ersatzavian/pai/Release/Rev-02/Fabrication/Reports/DRC/pai.html

Altium

# Design Rule Verification Report

Date: | | 2/10/2019
Time: | | 4:48:34 PM
Elapsed Time: | | 00:00:00
Filename: | | C:\Users\tbyrne\AppData\Local\TempReleases\Snapshot\1\Pcb\pai.PcbDoc

Warnings: | | 0
Rule Violations: | | 0

## Summary

Warnings | Count
Total | 0

Rule Violations | Count
Clearance Constraint (Gap=10mil) (All),(All) | 0
Short-Circuit Constraint (Allowed=No) (All),(All) | 0
Un-Routed Net Constraint ( (All) ) | 0
Modified Polygon (Allow modified: No), (Allow shelved: No) | 0
Width Constraint (Min=8mil) (Max=35mil) (Preferred=10mil) (All) | 0
Power Plane Connect Rule(Relief Connect )(Expansion=20mil) (Conductor Width=10mil) (Air Gap=10mil) (Entries=4) (All) | 0
Hole Size Constraint (Min=15mil) (Max=100mil) (All) | 0
Hole To Hole Clearance (Gap=10mil) (All),(All) | 0
Minimum Solder Mask Sliver (Gap=7mil) (All),(All) | 0
Silk To Solder Mask (Clearance=2mil) (IsPad),(All) | 0
Silk to Silk (Clearance=5mil) (All),(All) | 0
Net Antennae (Tolerance=0mil) (All) | 0
Height Constraint (Min=0mil) (Max=3000mil) (Prefered=500mil) (All) | 0
Total | 0
