ersatzavian/pai/Docs/0_5in_DC_jack_w_lift.PNG

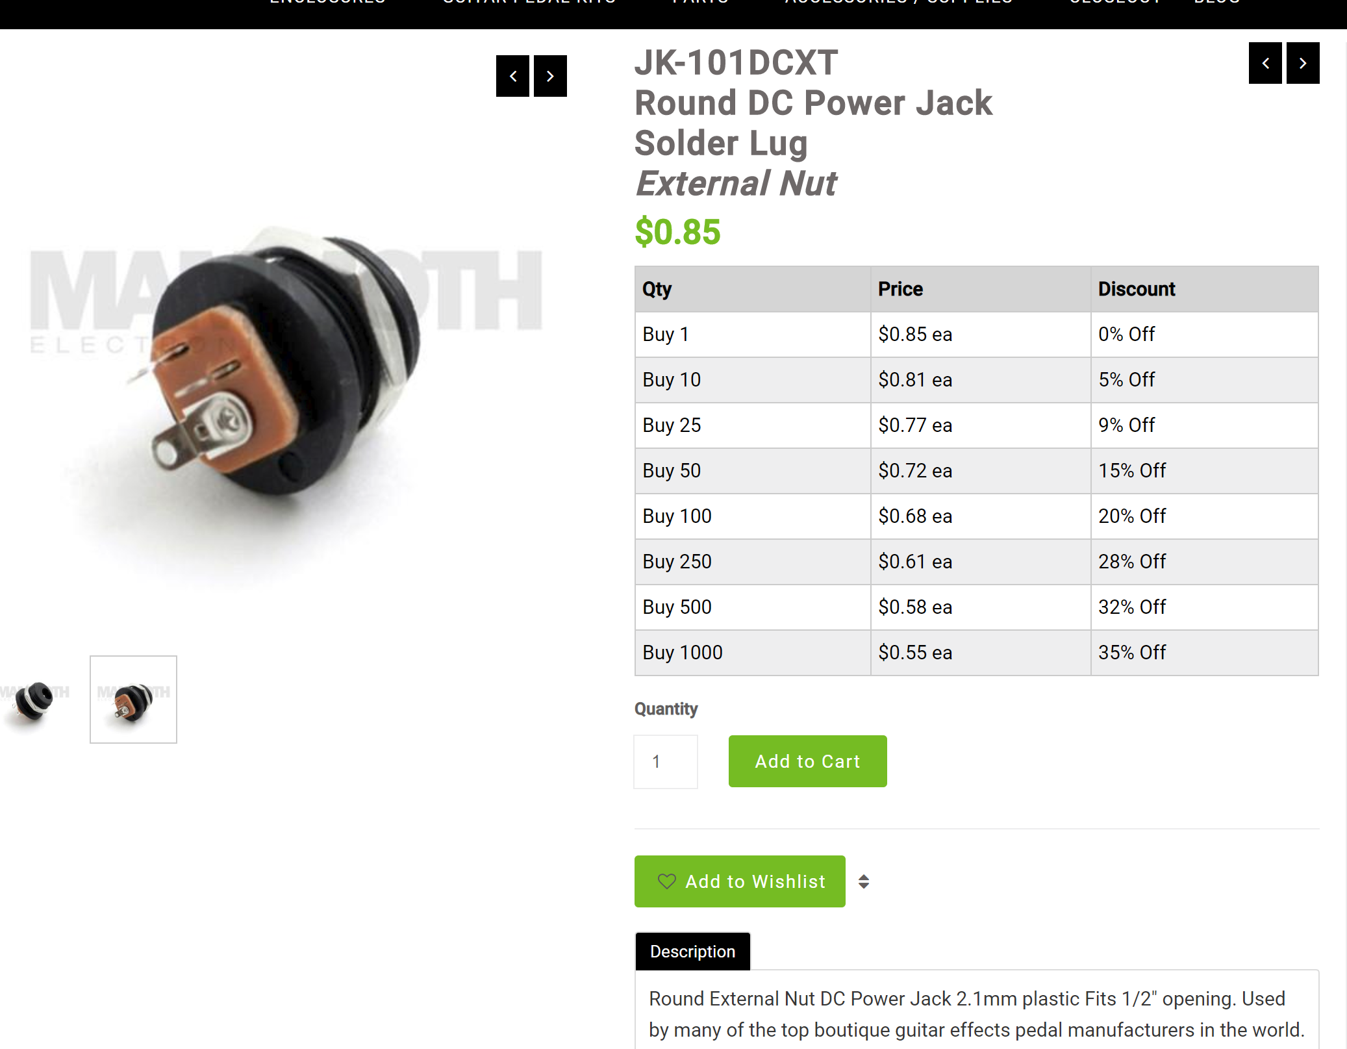
Docs/0_5in_DC_jack_w_lift.PNG
