ersatzavian/pai/Docs/1100-401-3.jpg

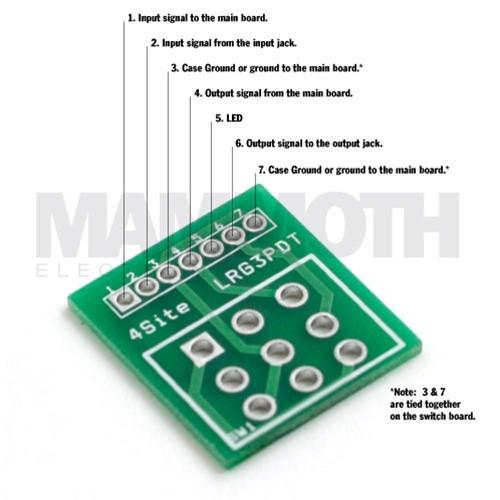
Docs/1100-401-3.jpg
