ersatzavian/pai/Docs/ART-LTL2F3VXKNT-DIM 1.jpg

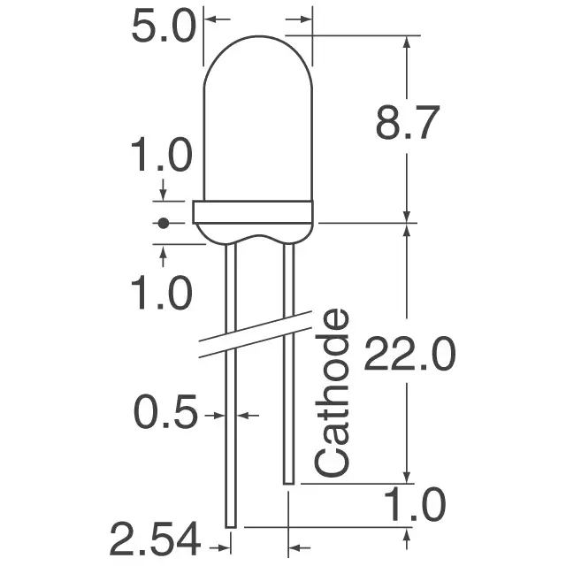
Docs/ART-LTL2F3VXKNT-DIM 1.jpg
