ersatzavian/pai/Docs/draft.JPG

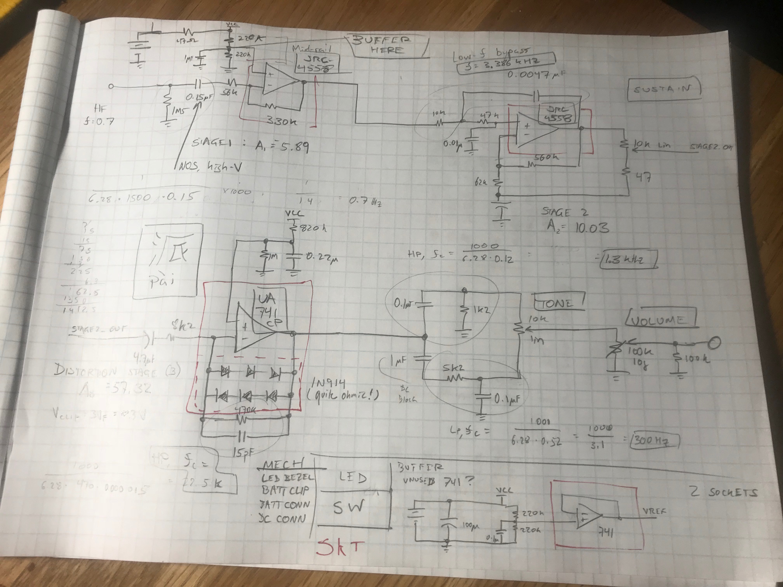
Docs/draft.JPG
