ersatzavian/pai/Docs/images/img_back.JPG

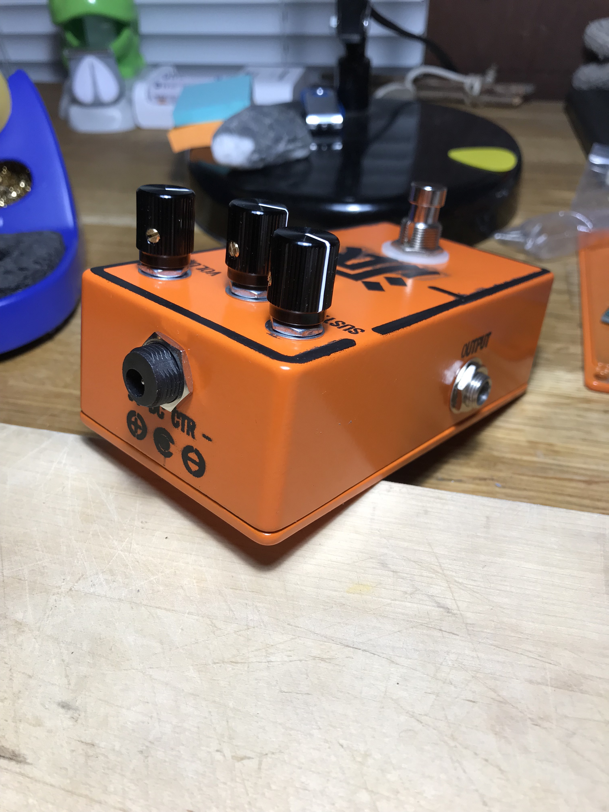
Docs/images/img_back.JPG
