ersatzavian/pai/Docs/images/pai_img_3d.png

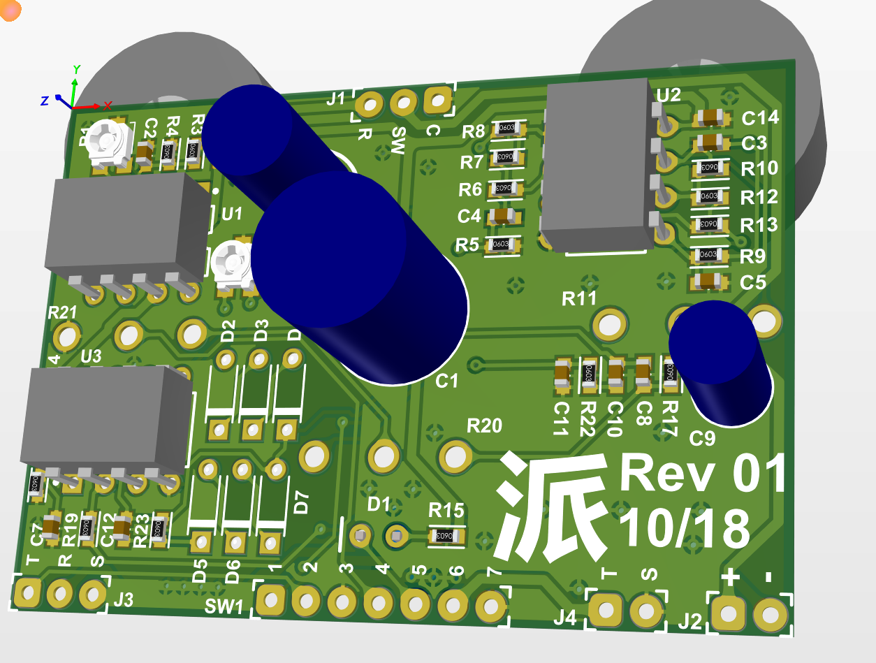
Docs/images/pai_img_3d.png
