ersatzavian/pai/Docs/images/rev1_img1.jpg

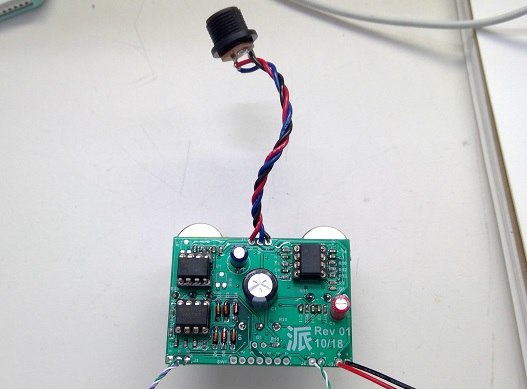
Docs/images/rev1_img1.jpg
