ersatzavian/pai/Docs/images/rev1_img2.jpg

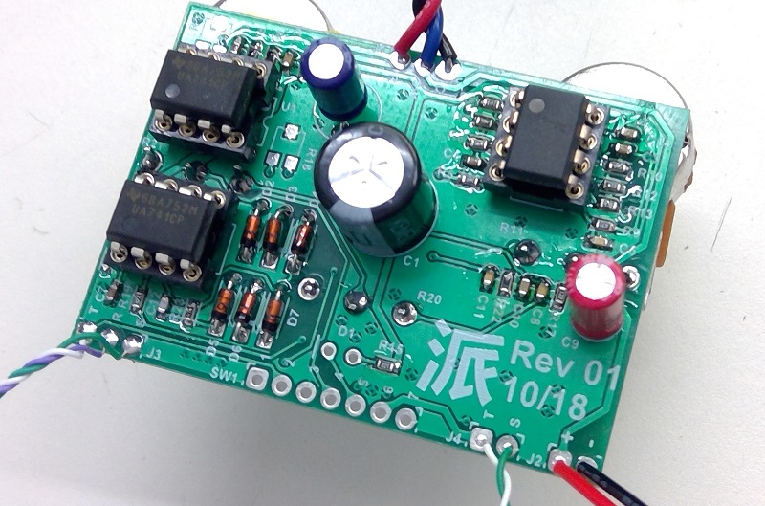
Docs/images/rev1_img2.jpg
