ersatzavian/pai/Docs/images/sw_backwards_in.png

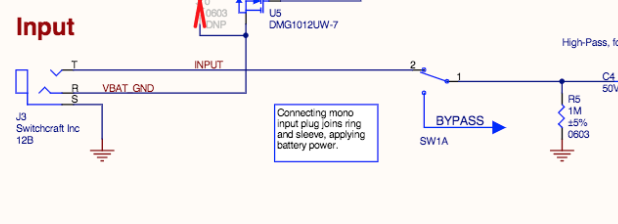
Docs/images/sw_backwards_in.png
