ersatzavian/pai/Docs/images/sw_backwards_out.png

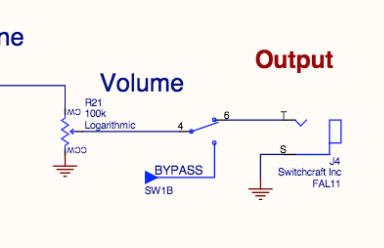
Docs/images/sw_backwards_out.png
