ersatzavian/pai/Docs/images/ua741c_pinout.PNG

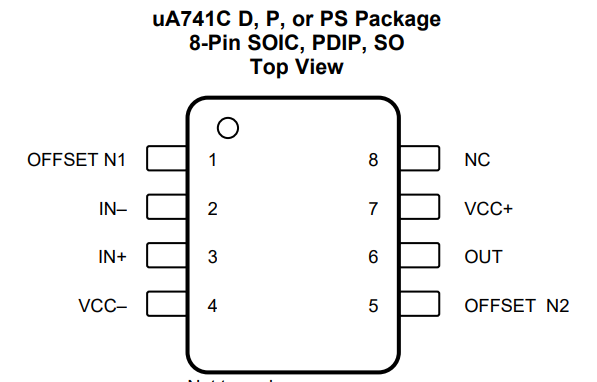
Docs/images/ua741c_pinout.PNG
