ersatzavian/pai/Docs/mammoth_125s_powdercoated.JPG

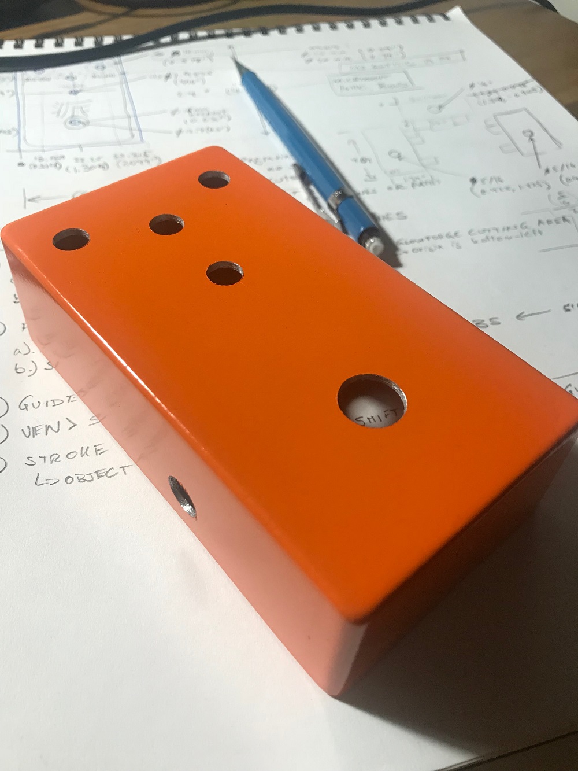
Docs/mammoth_125s_powdercoated.JPG
