ersatzavian/pai/Docs/pai_board_dimensions.JPG

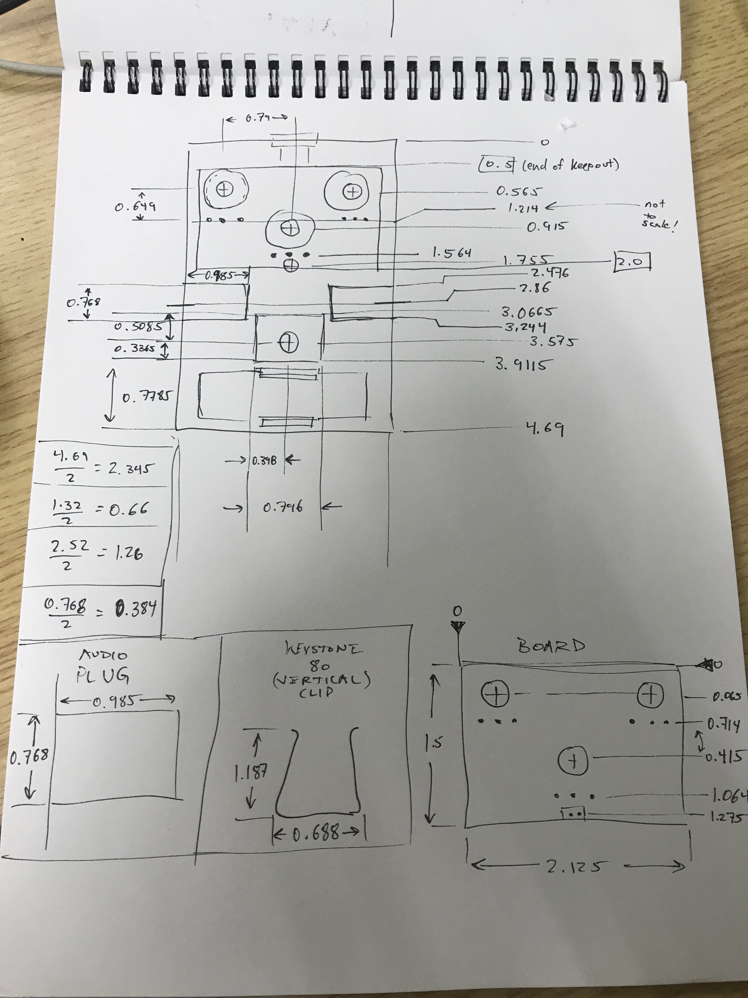
Docs/pai_board_dimensions.JPG
