ersatzavian/pai/Docs/pai_encl_draft.JPG

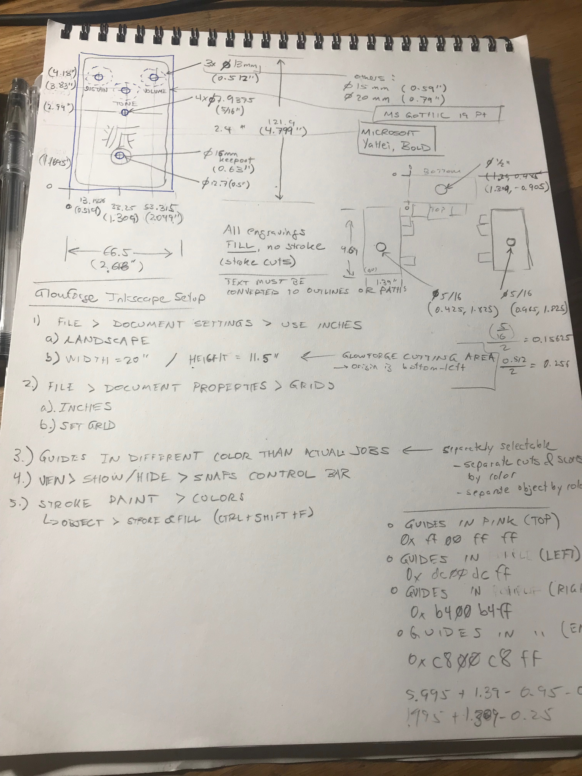
Docs/pai_encl_draft.JPG
