ersatzavian/pai/Docs/pcrat.gif

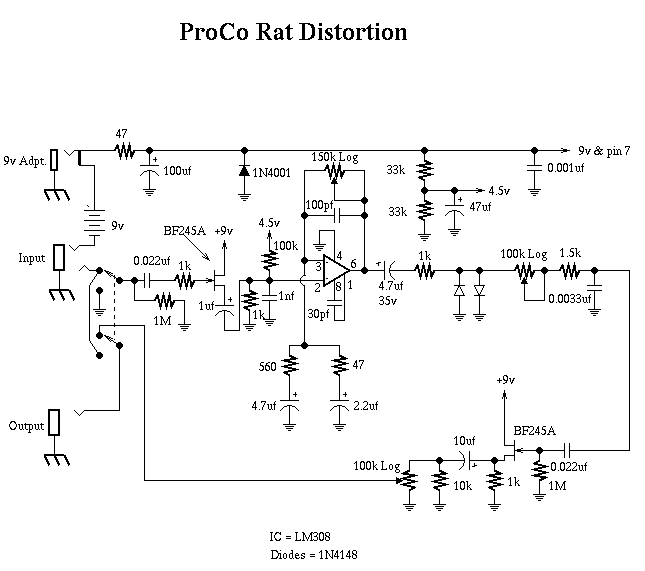
Docs/pcrat.gif
