ersatzavian/pai/Docs/reworks/Rev01/sus_knob_flip.PNG

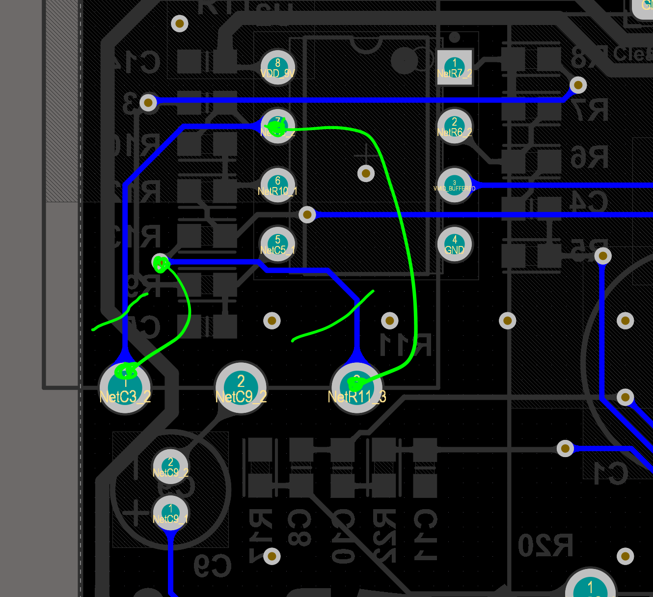
Docs/reworks/Rev01/sus_knob_flip.PNG
