ersatzavian/pai/Docs/reworks/Rev01/tone_knob_flip.PNG

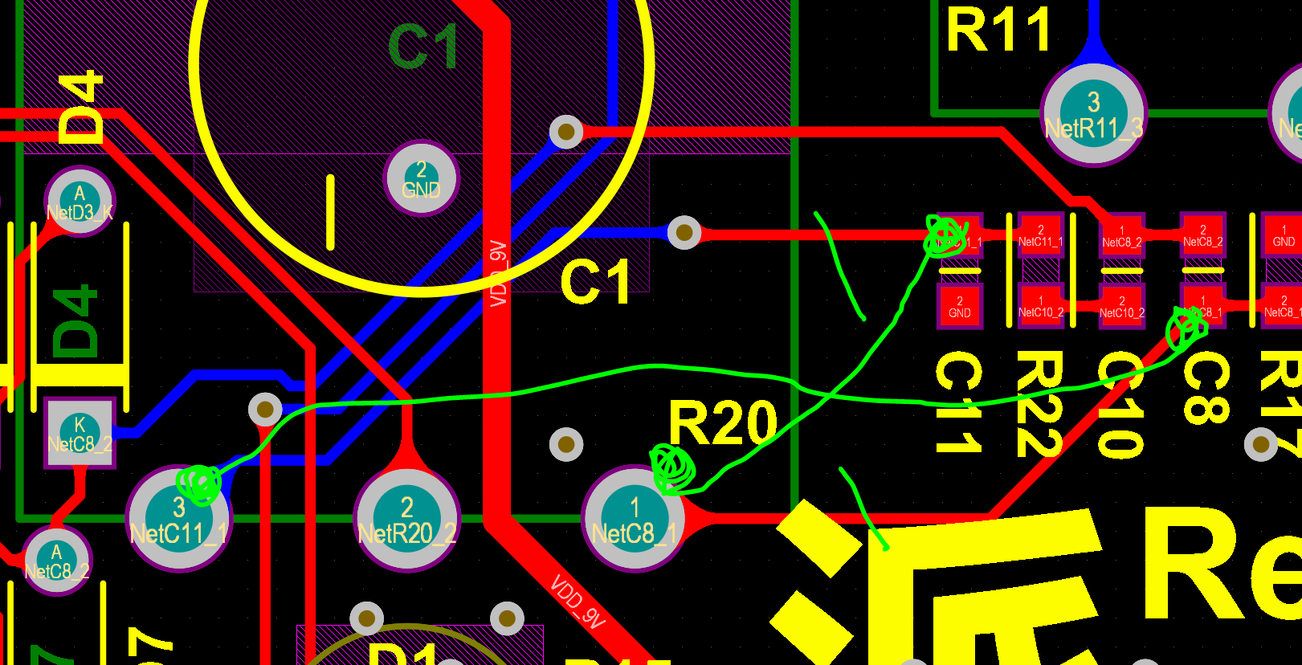
Docs/reworks/Rev01/tone_knob_flip.PNG
