ersatzavian/pai/Docs/reworks/Rev01/U7_rework.jpg

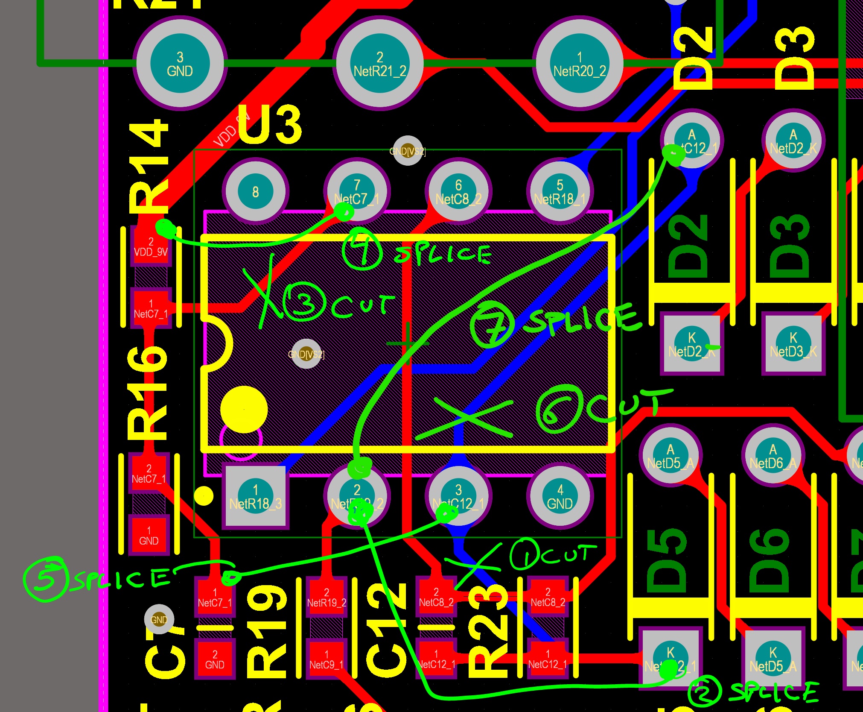
Docs/reworks/Rev01/U7_rework.jpg
