ersatzavian/pai/Docs/reworks/Rev01/v1_tone_fixed.PNG

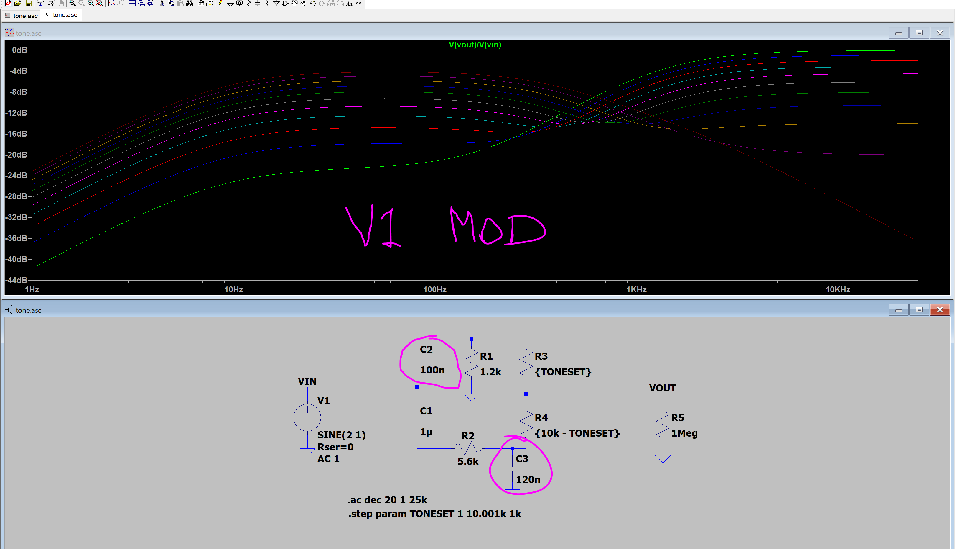
Docs/reworks/Rev01/v1_tone_fixed.PNG
