ersatzavian/pai/Docs/reworks/Rev01/v1_tone_wrong.PNG

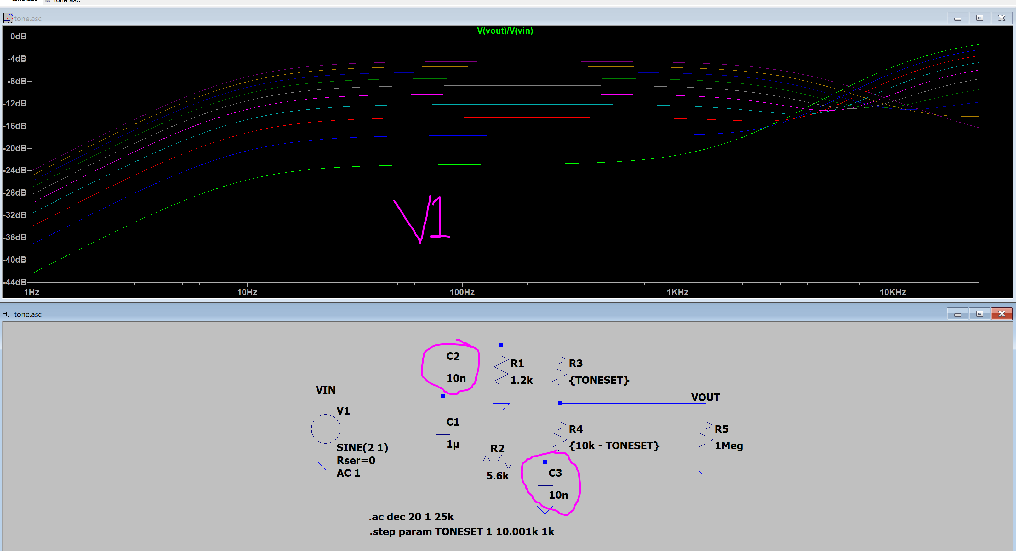
Docs/reworks/Rev01/v1_tone_wrong.PNG
