ersatzavian/pai/Docs/reworks/Rev01/vol_knob_flip.PNG

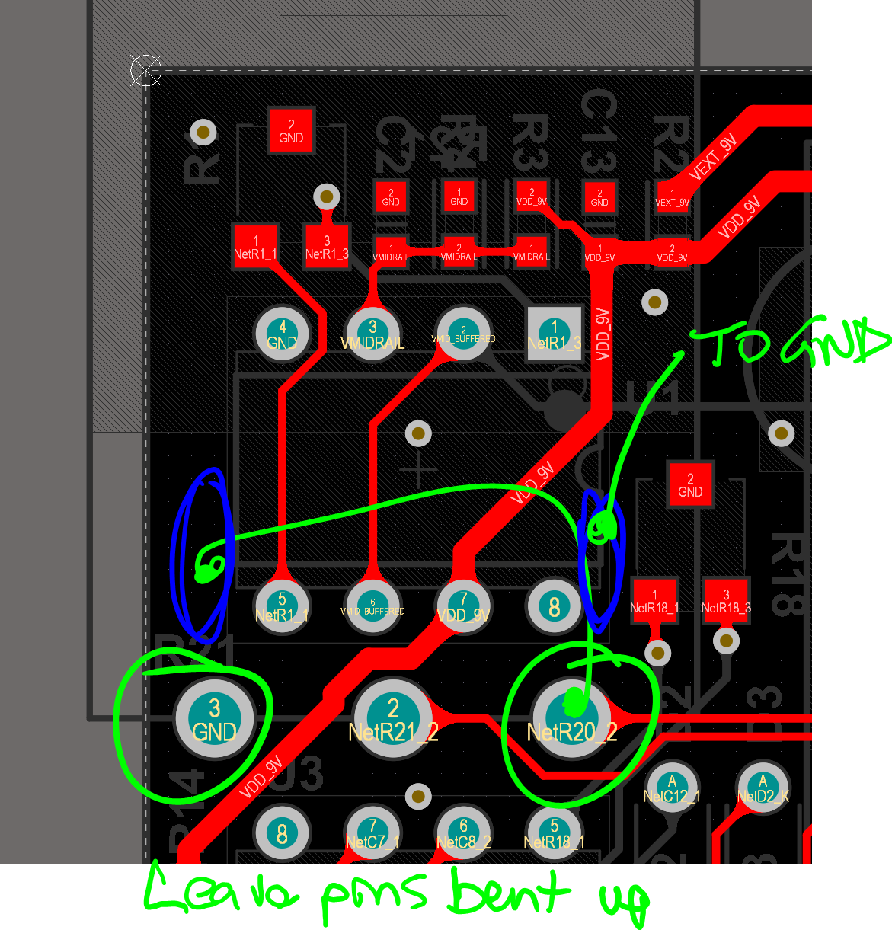
Docs/reworks/Rev01/vol_knob_flip.PNG
