ersatzavian/pai/Release/Rev-02/Assembly Base/BOM/Bill of Materials-pai(Base).xls

Comment | Description | Designator | LibRef | Manufacturer 1 PN | Quantity | Supplier 1 | Supplier Part Number 1
CAP | CAP CER 0.1UF 25V X5R 0603 | C8 | CAP-SMT-0001 |  | 1 | Digi-Key | 1276-1857-1-ND
CAP | CAP CER 1UF 25V X5R 0603 | C15 | CAP-SMT-0003 |  | 1 | Digi-Key | 1276-1858-1-ND
CAP | CAP CER 0.12UF 25V X7R 0603 | C11 | CAP-SMT-0002 |  | 1 | Digi-Key | 399-14951-1-ND
0.15µF | CAP CER 0.15UF 50V X7R 0603 | C4 | GCM188R71H154KA64D |  | 1 | Digi-Key | 490-11960-1-ND
0.22µF | CAP CER 0.22UF 25V X7R 0603 | C2, C7 | GRM188R71E224KA88D |  | 2 | Digi-Key | 490-3290-1-ND
1µF | CAP CER 1UF 25V X7R 0603 | C10, C13, C14 | GRM188R71E105KA12D |  | 3 | Digi-Key | 490-5307-1-ND
1M | RES SMD 1M OHM 5% 1/10W 0603 | R5, R16 | ERJ-3GEYJ105V |  | 2 | Digi-Key | P1.0MGCT-ND
1.2k | RES SMD 1.2K OHM 5% 1/10W 0603 | R15, R17 | ERJ-3GEYJ122V |  | 2 | Digi-Key | P1.2KGCT-ND
3PDT_SW_SOLDERBOARD |  | SW1 | 3PDT_SW_SOLDERBOARD |  | 1 | Mammoth Electronics
5.23k | RES SMD 5.23K OHM 1% 1/10W 0603 | R22 | ERJ-3EKF5231V |  | 1 | Digi-Key | P5.23KHCT-ND
8.2k | RES SMD 8.2K OHM 5% 1/10W 0603 | R19 | ERJ-3GEYJ822V |  | 1 | Digi-Key | P8.2KGCT-ND
9V_BATT | BATTERY CONNECT SNAP 9V 4" LEADS | J2 | BATT-0001 | 232 | 1 | Digi-Key | 36-232-ND
10k | RES SMD 10K OHM 5% 1/10W 0603 | R8 | ERJ-3GEYJ103V |  | 1 | Digi-Key | P10KGCT-ND
15pF | CAP CER 15PF 50V NP0 0603 | C12 | GCM1885C1H150JA16D |  | 1 | Digi-Key | 490-4957-1-ND
47 | RES SMD 47 OHM 5% 1/4W 0603 | R2, R13 | ERJ-PA3J470V |  | 2 | Digi-Key | P47.00BZCT-ND
47k | RES SMD 47K OHM 5% 1/10W 0603 | R9 | ERJ-3GEYJ473V |  | 1 | Digi-Key | P47KGCT-ND
56k | RES SMD 56K OHM 5% 1/10W 0603 | R6 | ERJ-3GEYJ563V |  | 1 | Digi-Key | P56KGCT-ND
62k | RES SMD 62K OHM 5% 1/10W 0603 | R12 | ERJ-3GEYJ623V |  | 1 | Digi-Key | P62KGCT-ND
220k | RES SMD 220K OHM 5% 1/4W 0603 | R3, R4 | ERJ-PA3J224V |  | 2 | Digi-Key | P220KBZCT-ND
330k | RES SMD 330K OHM 5% 1/10W 0603 | R7 | ERJ-3GEYJ334V |  | 1 | Digi-Key | P330KGCT-ND
470k | RES SMD 470K OHM 5% 1/10W 0603 | R23 | ERJ-3GEYJ474V |  | 1 | Digi-Key | P470KGCT-ND
560k | RES SMD 560K OHM 5% 1/10W 0603 | R10 | ERJ-3GEYJ564V |  | 1 | Digi-Key | P560KGCT-ND
820k | RES SMD 820K OHM 5% 1/10W 0603 | R14 | ERJ-3GEYJ824V |  | 1 | Digi-Key | P820KGCT-ND
4700pF | CAP CER 4700PF 25V X7R 0603 | C3 | GCM188R71E472KA37D |  | 1 | Digi-Key | 490-11959-1-ND
10000pF | CAP CER 10000PF 25V X7R 0603 | C5 | GRM188R71E103KA01J |  | 1 | Digi-Key | 490-11997-1-ND
CAP-POL | CAP ALUM 4.7UF 20% 25V RADIAL | C9 | CAP-TH-0003 | 860020472001 | 1 | Digi-Key | 732-8818-1-ND
CAP-POL | CAP ALUM 10UF 20% 25V RADIAL | C6 | CAP-TH-0001 | ECA-1EM100B | 1 | Digi-Key | P19522CT-ND
CAP-POL | CAP ALUM 220UF 20% 35V THRU HOLE | C1 | CAP-TH-0002 | ESH227M035AH9AA | 1 | Digi-Key | 399-15681-ND
DIO-GEN | DIODE GEN PURP 75V 200MA DO35 | D2, D3, D4, D5, D6, D7 | DIO-GEN-0001 | 1N914 | 6 | Digi-Key | 1N914MS-ND
LED-Blue | LED BLUE CLEAR T-1 3/4 T/H | D1 | LED-0003 | LTL2T3TBK5 | 1 | Digi-Key | 160-1610-ND
MECH | BATTERY HOLDER CLIP 9V | M1 | MECH-0001 | 80 | 1 | Digi-Key | 36-80-ND
MECH | LED Bezel, 5mm LED, 5/16" Hole, Chrome | M2 | MECH-0002 | 4SLEDBZ5-1 | 1 | Mammoth Electronics | 4SLEDBZ5-1
MONO_JACK | CONN JACK MONO 6.35MM PNL MNT | J4 | AUD-CN-0002 | FAL11 | 1 | Digi-Key | SC1847-ND
NFET_SOT323 | MOSFET N-CH 20V 1A SOT323 | U4, U5 | NFET-0001 |  | 2 | Digi-Key | DMG1012UW-7DICT-ND
POT | Potentiometer, 10k, Linear Taper, 16mm, Single Gang, TH RA | R11, R20 | POT-0004 | B10K | 2 | Mammoth Electronics | B10K
POT | Potentiometer, 100k, Log Taper, 16mm, Single Gang, TH RA | R21 | POT-0017 | B100K | 1 | Mammoth Electronics | A100K
PWR_JACK_SW | CONN PWR JACK 2X5.5MM SOLDER | J1 | PWR-CN-0001 | PJ-011A | 1 | Digi-Key | CP-011A-ND
RC4558P | Dual General-Purpose Operational Amplifier, 10 to 30 V, 0 to 70 degC, 8-pin DIP (P8), Pb-Free (RoHS) | U2 | RC4558P |  | 1 | Digi-Key | 296-1414-5-ND
STEREO_JACK | CONN JACK STEREO 6.35MM PNL MNT | J3 | AUD-CN-0001 | 12B | 1 | Digi-Key | SC1094-ND
UA741CP | General-Purpose Operational Amplifier, 7 to 36 V, 0 to 70 degC, 8-pin DIP (P8), Pb-Free (RoHS) | U1, U3 | UA741CP |  | 2 | Digi-Key | 296-11107-5-ND
