ersatzavian/pai/Release/Rev-02/Assembly Base/ExportSTEP/pai(Base).step

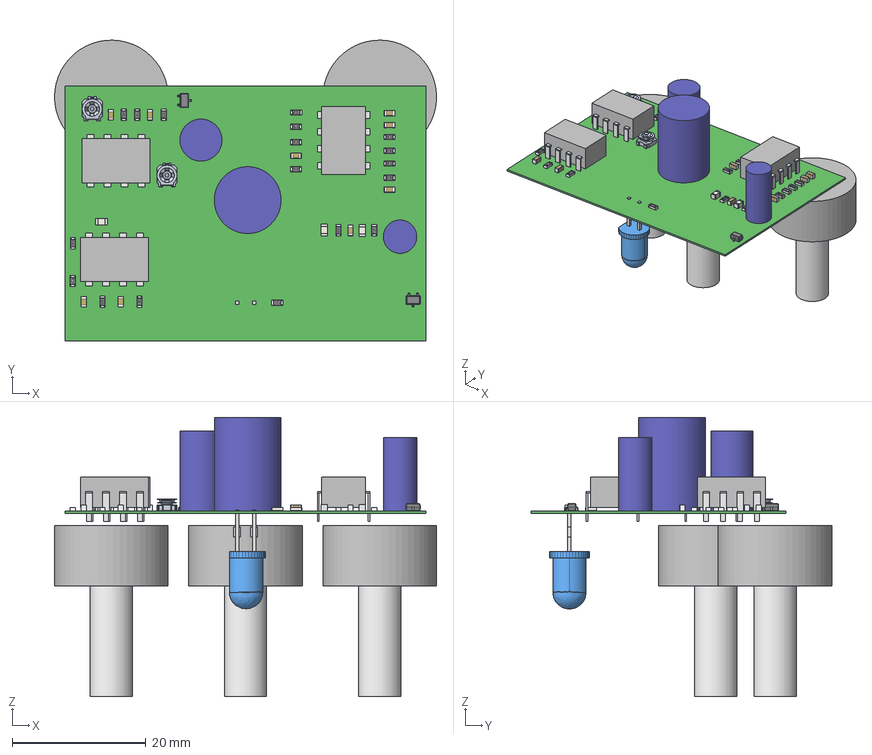
[picture p27: CAD file, 2019-02-11]
Release/Rev-02/Assembly Base/ExportSTEP/pai(Base).step
57.1 x 45.0 x 41.7 mm
Extruded x 84
capacitor_0603 x 9
35w x 2
User_Library-LEDd5B_Board_1
User_Library-LEDd5B_Extruded_5 x 2
User_Library-LEDd5B_Extruded_6 x 2
User_Library-LEDd5B_Sphere_1
User_Library-LEDd5B_Extruded_7
User_Library-LEDd5B_Cylinder_1
User_Library-LEDd5B_Extruded_8
User_Library-LEDd5B_Extruded_9
Open_CASCADE_STEP_translator_6.8_2.1.1 x 2
Leader x 6
