ersatzavian/pai/(list of files, cad)

Other CAD files:
Release/Rev-01/Assembly/ExportSTEP/pai.step
