ersatzavian/pai/Docs/reworks/Rev01/u7_issue.jpg

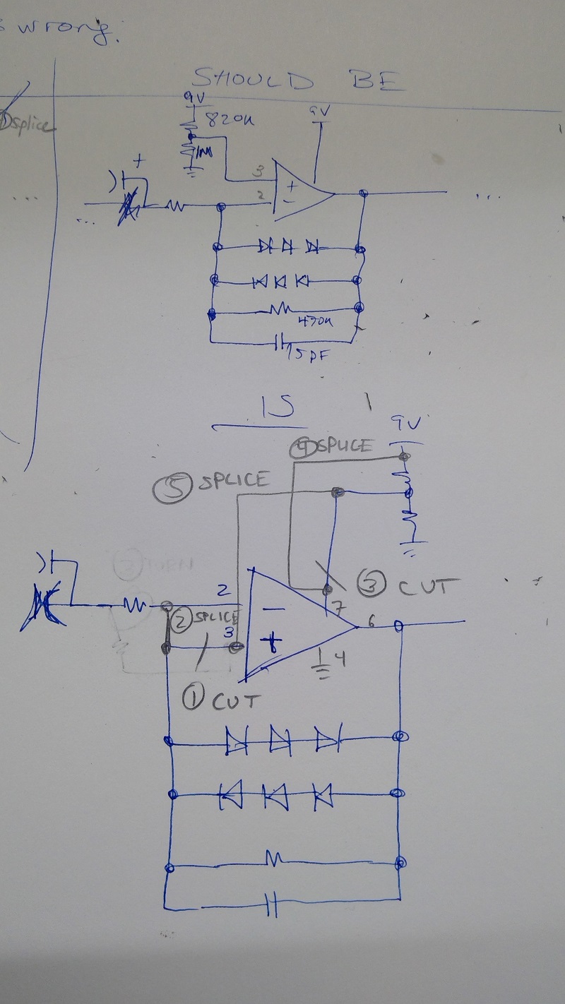
Docs/reworks/Rev01/u7_issue.jpg
