ersatzavian/pai/Docs/Mammoth PreDrill Template 125B Vertical (with measurements).pdf

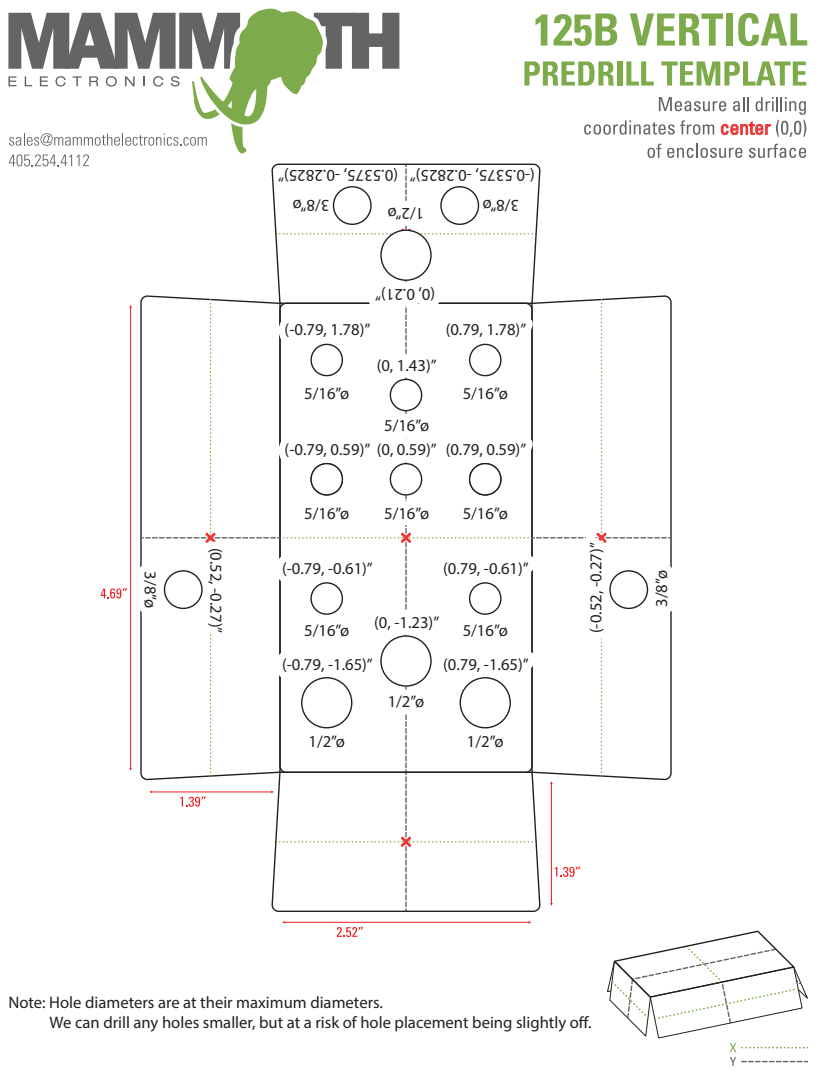
[picture p29: page 1]

Note: Hole diameters are at their maximum diameters.
We can drill any holes smaller, but at a risk of hole placement being slightly o.
