ersatzavian/pai/Release/Rev-02/Assembly Base/Schematic Prints.PDF

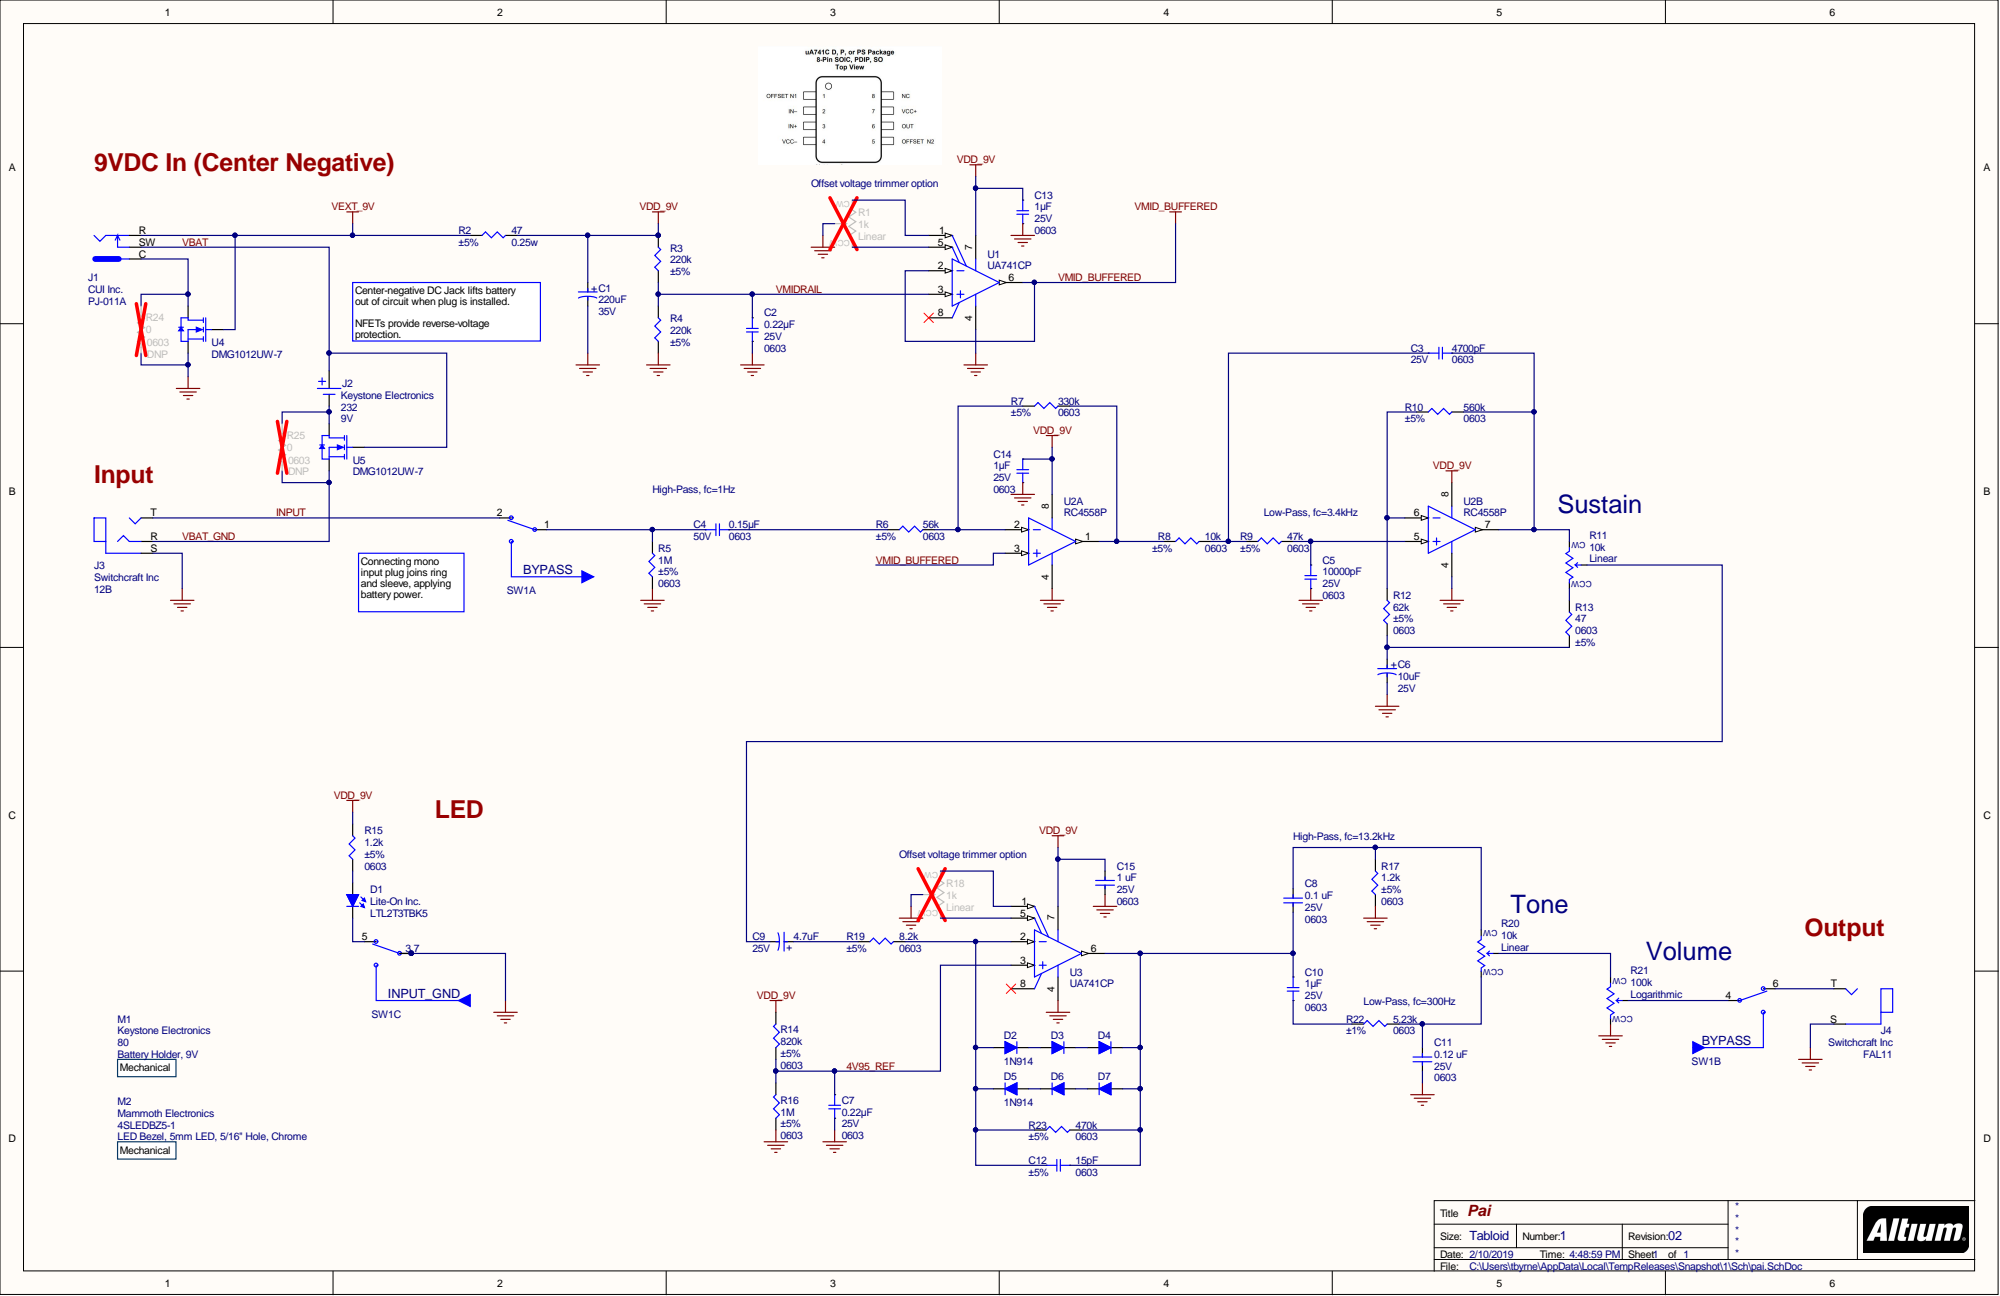
[picture p30: page 1]

Offset voltage trimmer option

Center-negative DC Jack lifts battery
out of circuit when plug is installed.

NFETs provide reverse-voltage
protection.

Connecting mono
input plug joins ring
and sleeve, applying
battery power.

Pai Title | * * * * *

Size: Tabloid | Number: 1 | Revision: 02
Date: 2/10/2019 Time: 4:48:59 PM | | Sheet 1 of 1

C:\Users\tbyrne\AppData\Local\TempReleases\Snapshot\1\Sch\pai.SchDoc
File:
