ersatzavian/pai/Release/Rev-02/Assembly Base/AssemblyDrawing.pdf

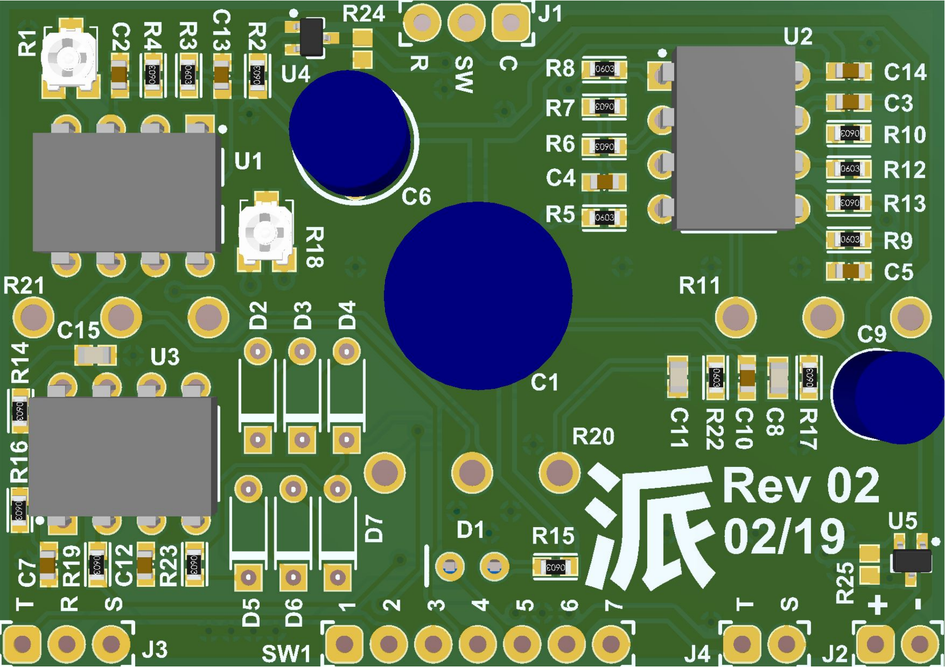
[picture p31: page 1]

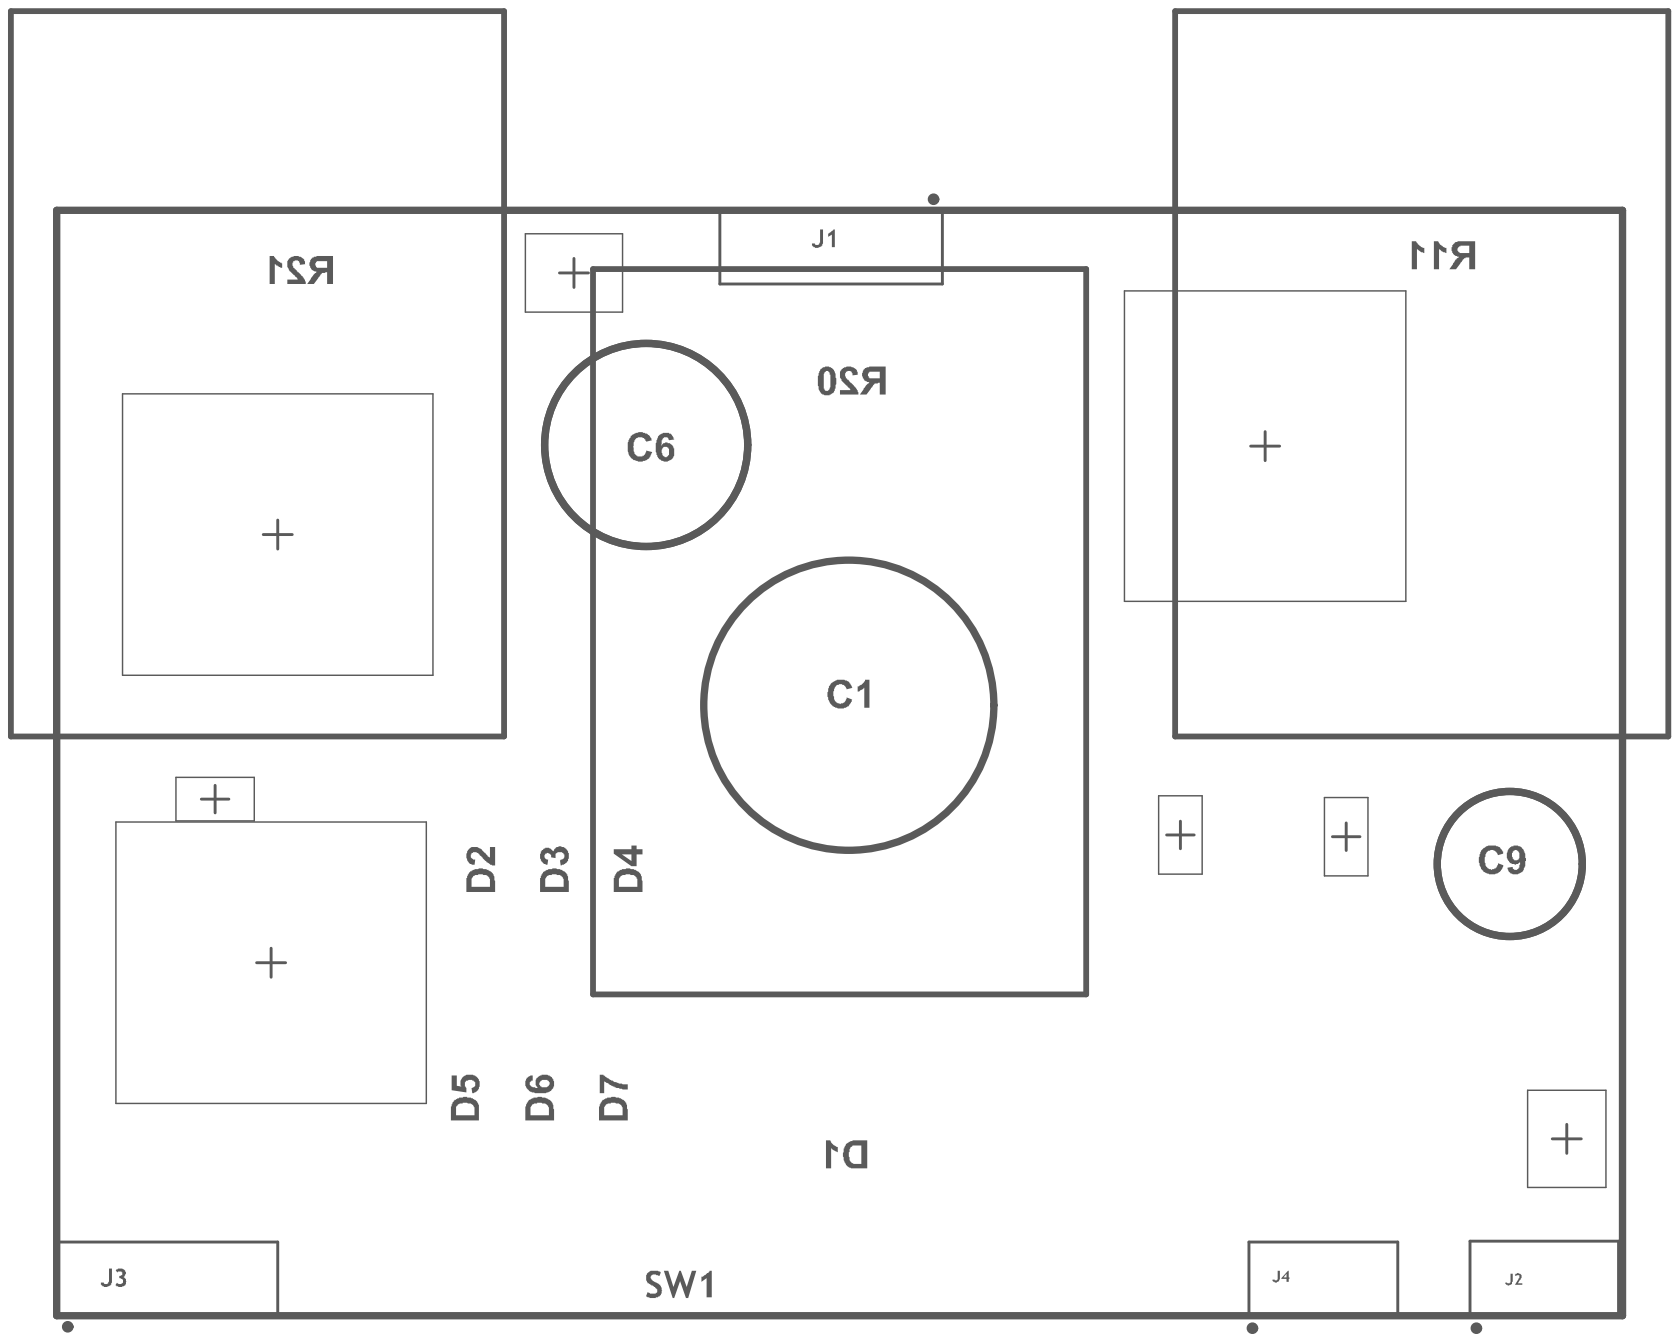
[picture p32: page 2]
