ersatzavian/pai/Docs/71.PDF

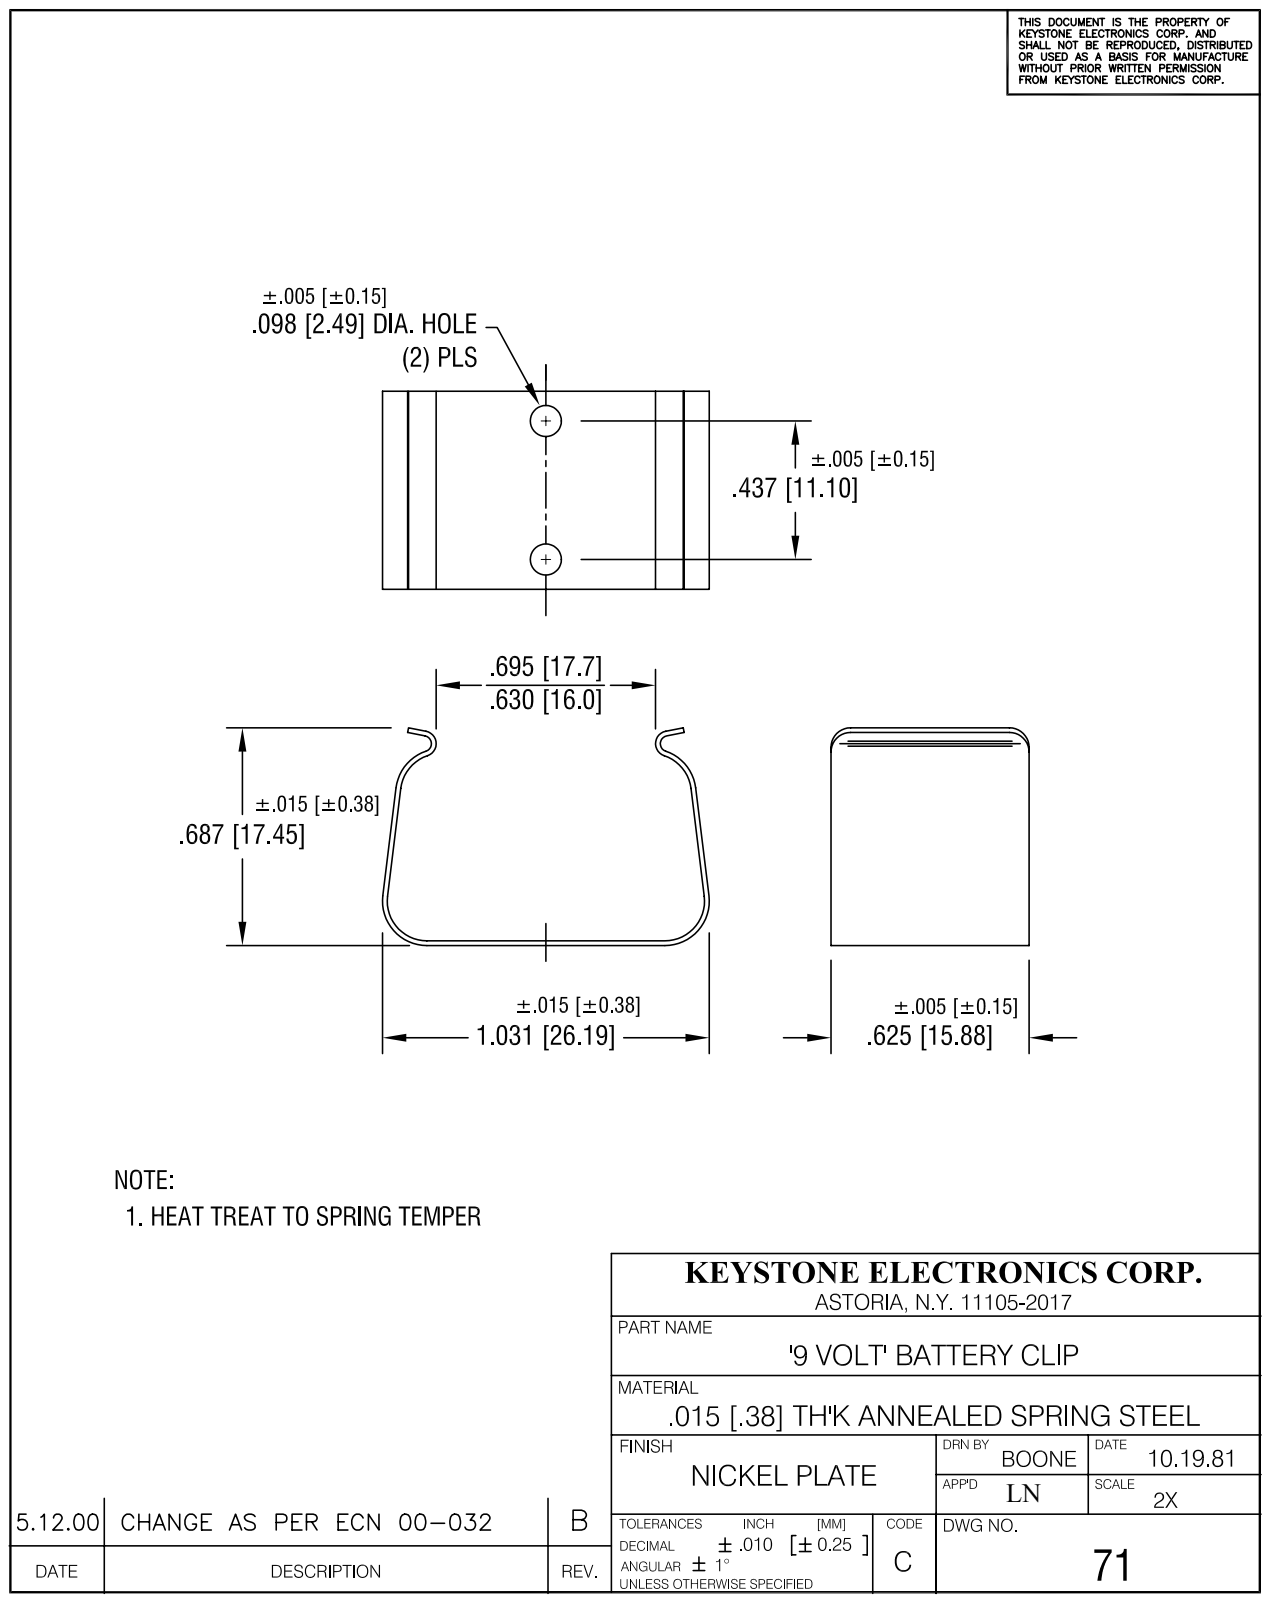
[picture p33: page 1]
