ersatzavian/pai/Docs/switchcraft_712A.pdf

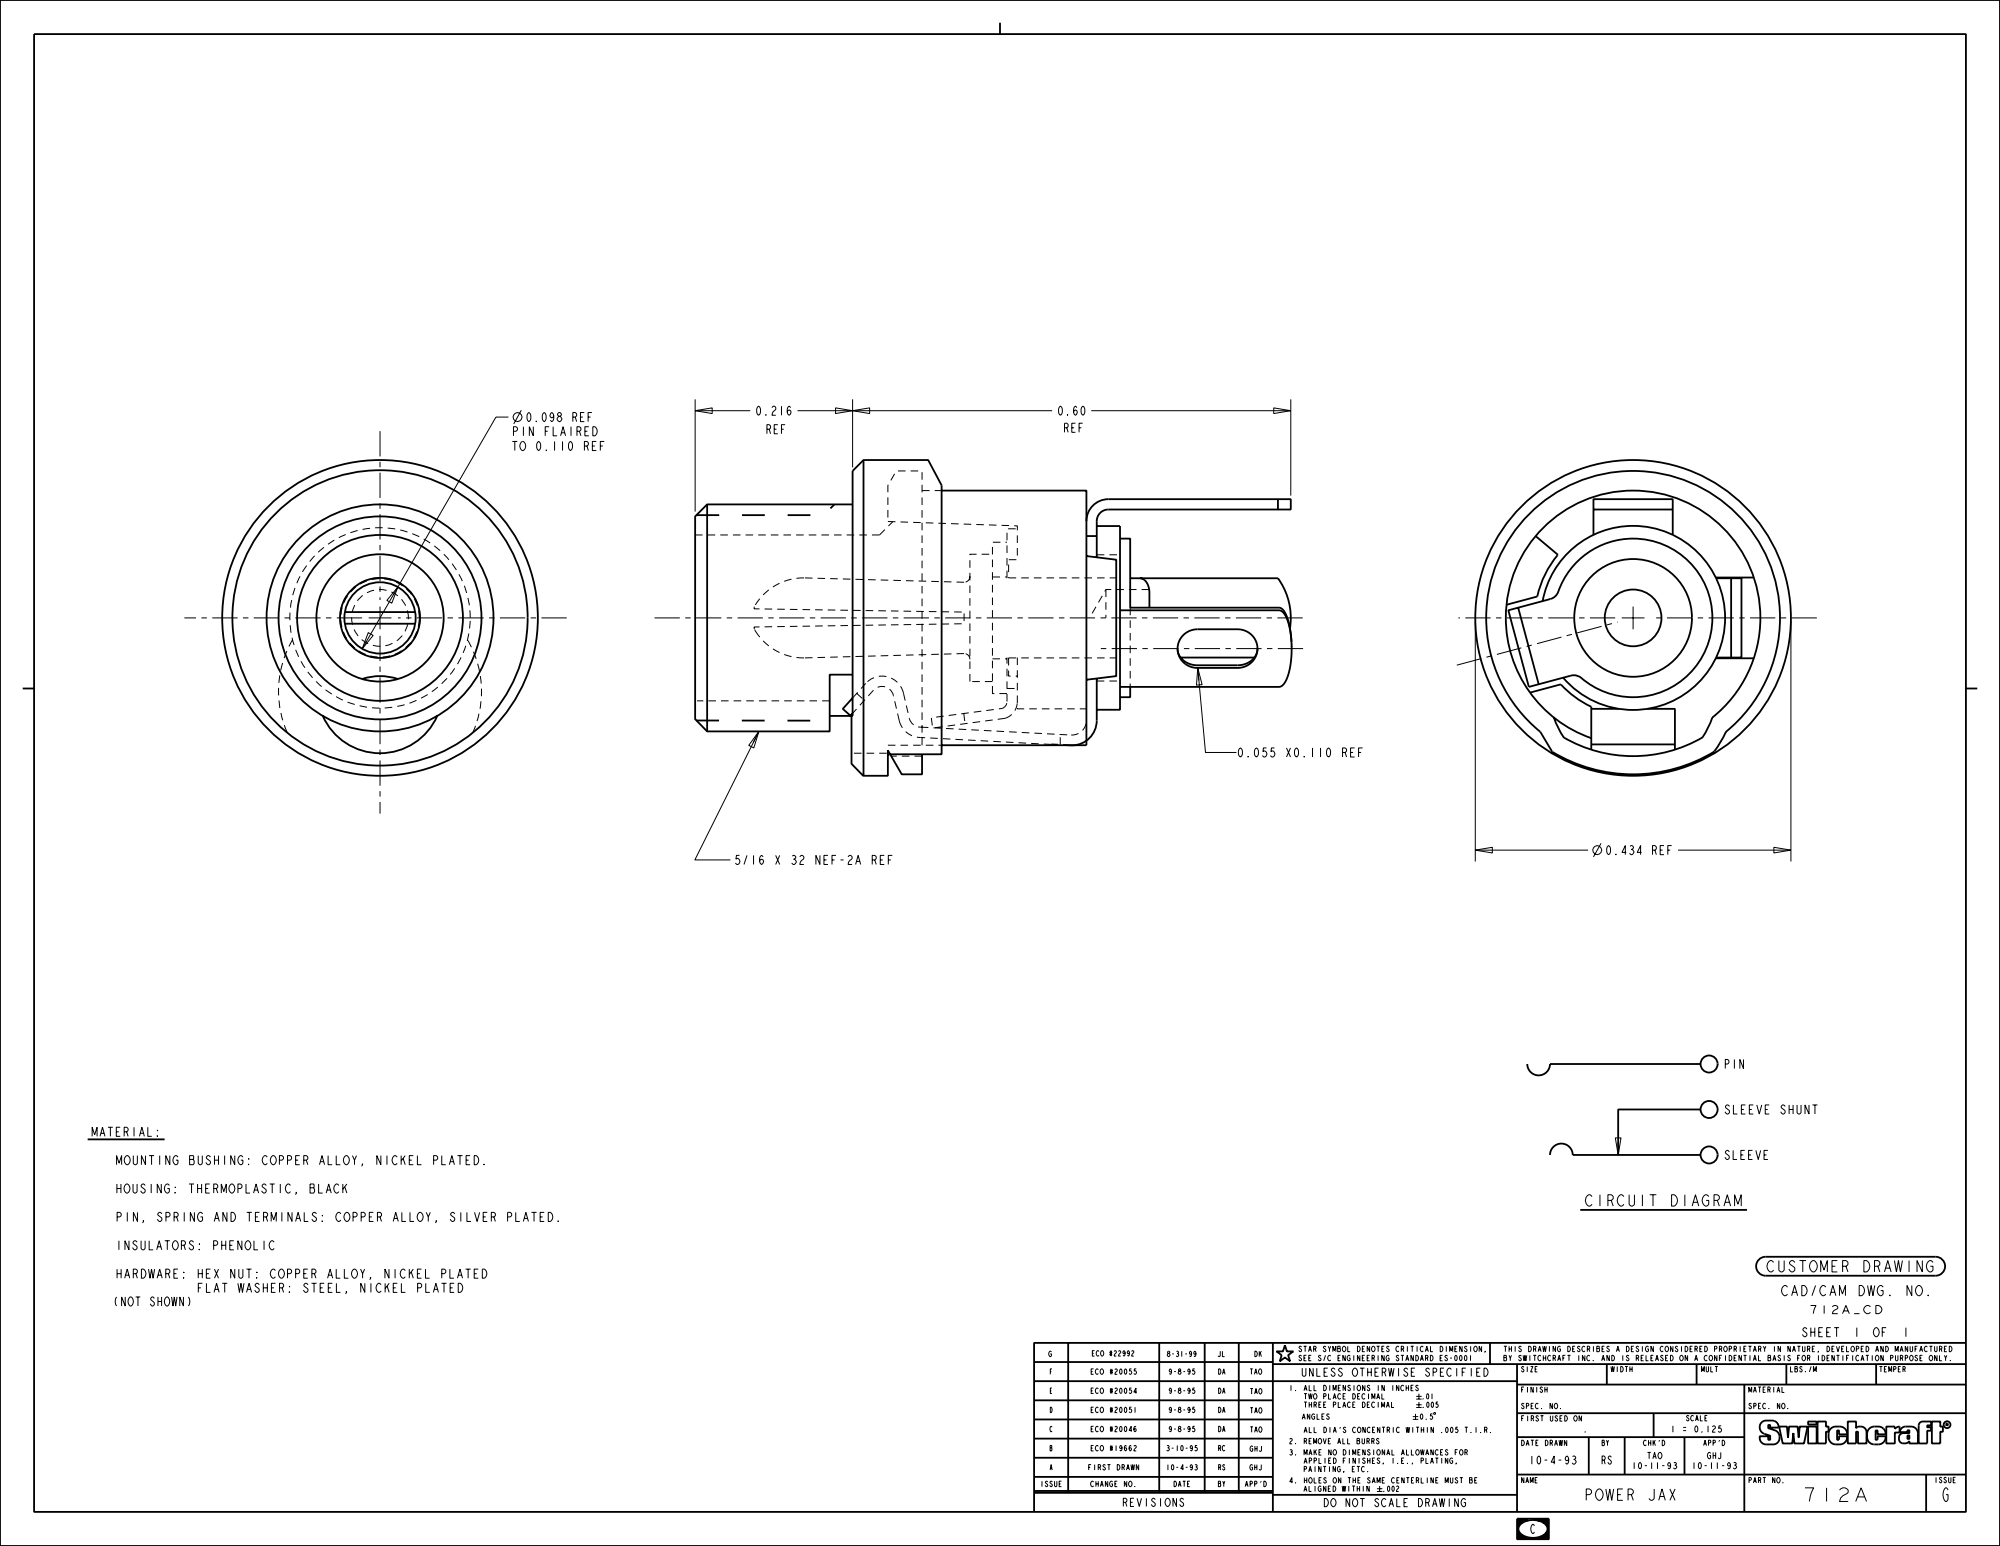
[picture p34: page 1]
