ersatzavian/pai/Release/Rev-01/Assembly/AssemblyDrawing.pdf

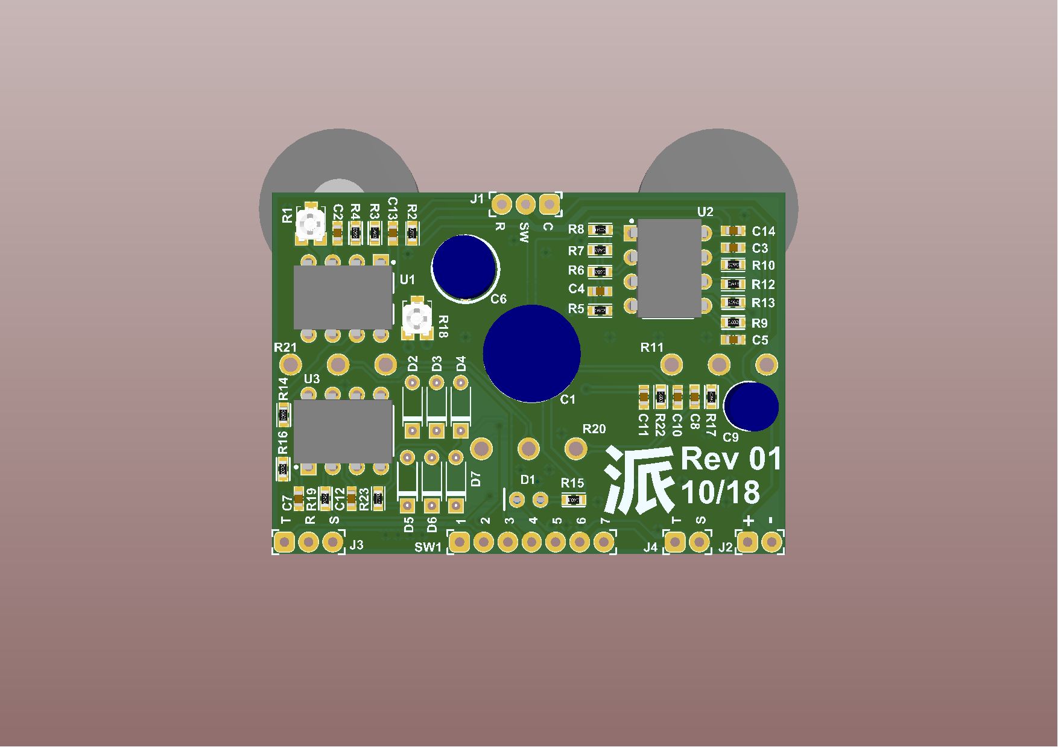
[picture p35: page 1]

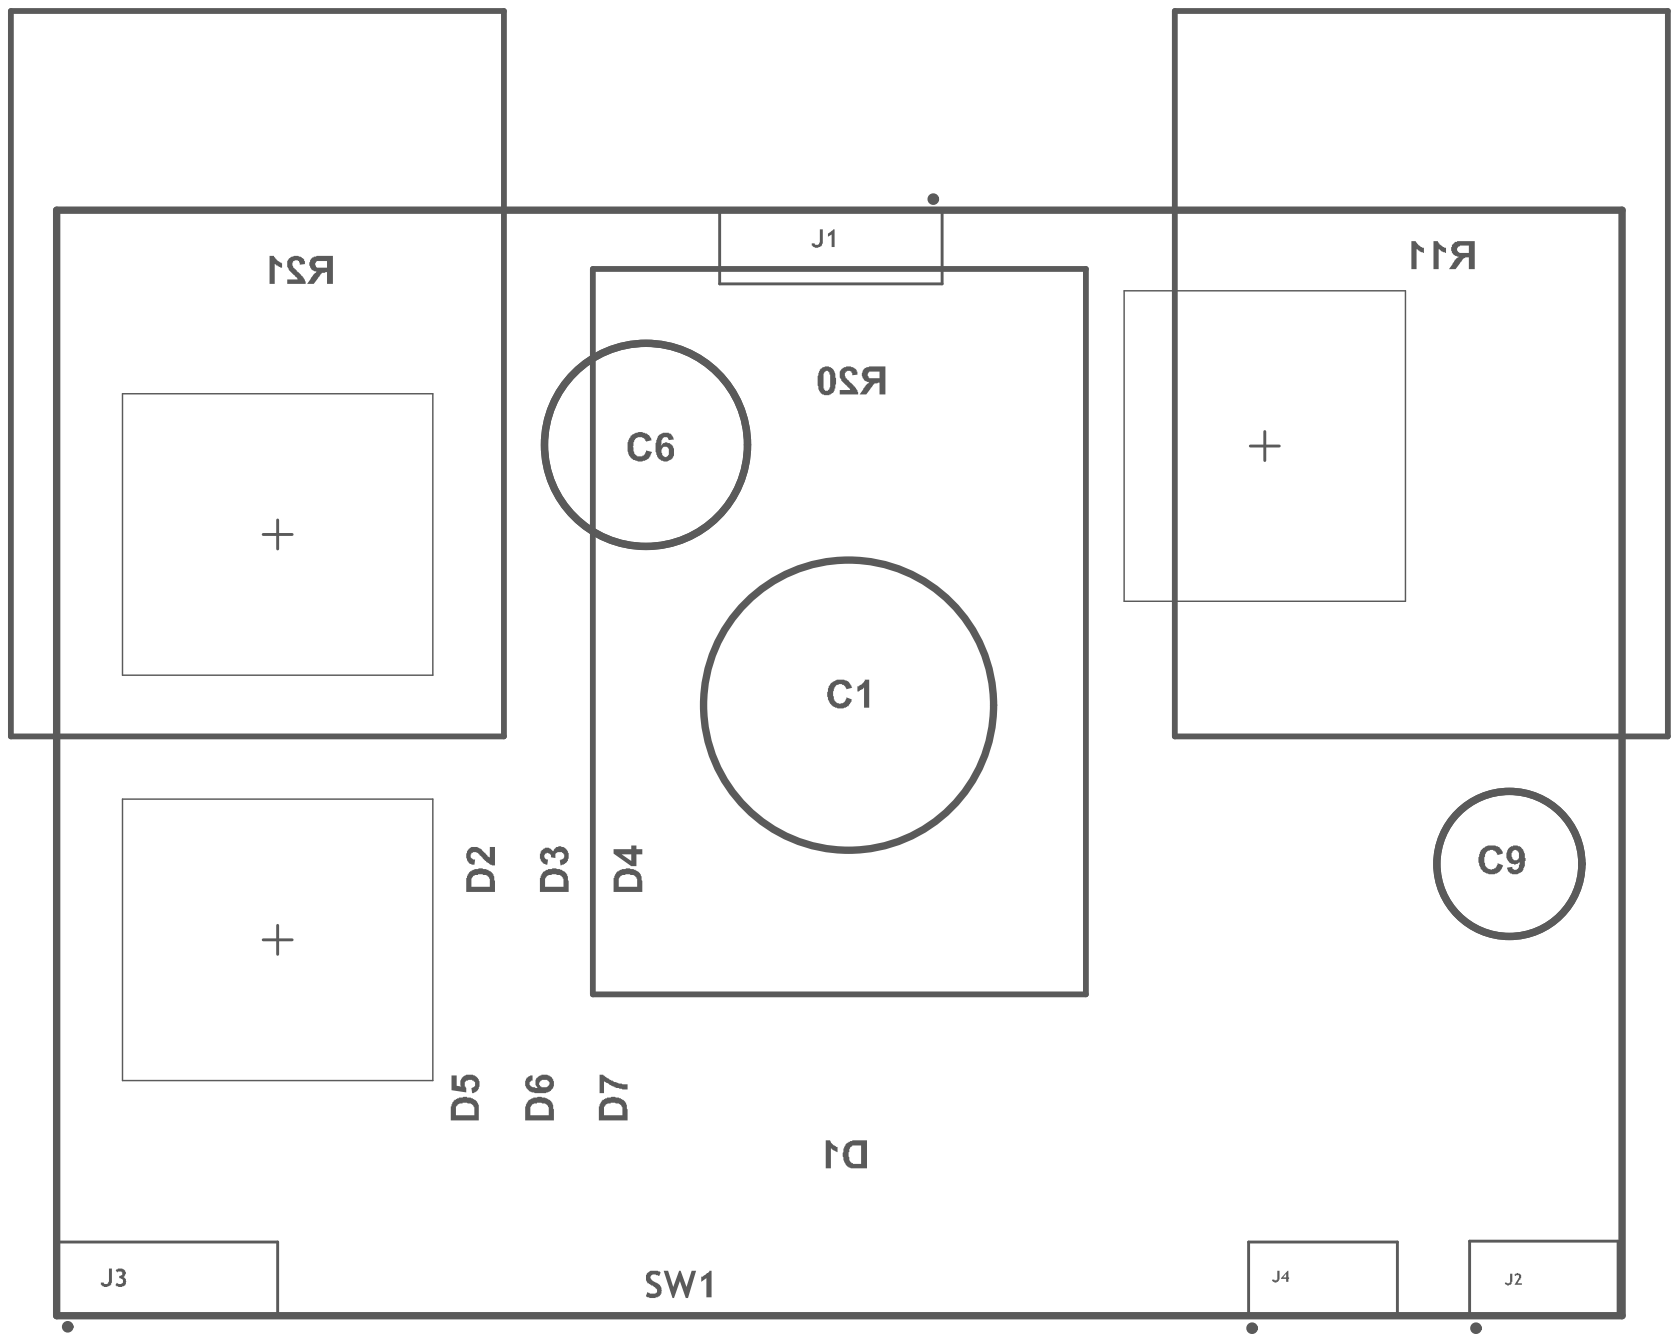
[picture p36: page 2]
