ersatzavian/pai/Docs/spice/tone.asc

C1: cap; 1µ
C2: cap; 100n
C3: cap; 120n
R1: res; 1.2k
R2: res; 5.6k
R3: res; {TONESET}
R4: res; {10k - TONESET}
R5: res; 1Meg
V1: voltage; SINE(2 1); AC 1; Rser=0
Named nets: 0, VOUT, VIN
.ac dec 20 1 25k
.step param TONESET 1 10.001k 1k
