ersatzavian/pai/(list of files, drawings)

Other design files:
pai.PrjPCB
Pcb/pai.PcbDoc
Sch/pai.SchDoc
