ersatzavian/pai/(commit log)

2018-10-01 first+1 commit
    [pai.PcbDoc, pai.PrjPCB, pai.SchDoc]
2018-10-01 updated some docs for library work later
    [pai.PrjPCB, pai.SchDoc]
2018-10-04 updated gitignore, added datasheets
    [pai.PrjPCB, pai.SchDoc]
2018-10-07 schematic draft complete, ready for finalization and placement start
    [pai.SchDoc]
2018-10-08 annotated, numbered, and updated template
    [pai.PrjPCB, pai.SchDoc]
2018-10-08 placement complete. Lots of symbol corrections
    [pai.PcbDoc, pai.PrjPCB, pai.SchDoc]
2018-10-08 switched to 2-layer 1.6mm stackup because it's a tenth the cost of 4-layer on electrow. Like under a board
    [pai.PcbDoc]
2018-10-08 board ready to release
    [pai.PrjPCB]
2018-10-08 attempting release
    [pai.PrjPCB]
2018-10-08 generated rev 01 gerbers, sending to fab. Need to fix output file gen and releaser
    [Bill of Materials-pai.xlsx, pai.PrjPCB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]
2018-10-08 prepping for attempted release
    [pai.PrjPCB]
2018-10-08 released rev 01
    [Bill of Materials-pai.xlsx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]
2018-10-09 fixed missing bottom mask layer in gerbers
    [pai.PrjPCB]
2018-10-09 fixed missing .GBS in gerber package, added zipped releases to gitignore
    [Bill of Materials-pai.xlsx, pai.step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]
2018-10-15 updated enclosure .svg, ready to etch
2018-10-31 brought up first rev 1 prototype, documented issues
2018-11-21 fixed fuzz-stage rework diagram, which failed to move both pairs of diodes to the correct input
    [pai.SchDoc]
2018-11-26 cleaned up spurious non-release output files, added sims of tone section with and without incorrect Rev 01 values
    [Bill of Materials-pai.xlsx]
2018-11-26 created stencil version of enclosure SVG
2018-12-05 updated README to clarify some things found while building up 2nd, 3rd, and 4th units
    [pai.PrjPCB]
2019-02-11 updated pai to rev 2, preparing to release
    [pai.PrjPCB, pai.SchDoc]
2019-02-11 trying to get Altium to let me release this...
    [pai.PrjPCB]
2019-02-11 Released Rev 02
    [Bill of Materials-pai(Base).xls, pai(Base).step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]
2019-12-21 removing in-progess project outputs folder from version control
    [pai.GBL, pai.GM1, pai.GTL, pai.GTO, pai.GTP, pai.GTS]
